fpp3/cnc/README.md

# cnc
Trabajo Practico Integrador de 4to año de la carrera Ingeniería Electrónica en la Universidad Tecnológica Nacional, Facultad Regional Córdoba. Materias involucradas: Electrónica Aplicada II, Técnicas Digitales II, Maquinas e Instalaciones Electricas
