fpp3/cnc/docs/anteproyecto/chapters/2-electronica_aplicada_2.tex

\chapter{Electrónica Aplicada II: Sensado de Corriente y Sensorless Endstops}
\label{sec:electronica_aplicada_2}

En el marco de la asignatura Electrónica Aplicada II, el proyecto aborda el diseño y análisis de una etapa analógica
orientada a la medición de corriente en los accionamientos y a la detección electrónica de límites mecánicos o
atascamientos (\textit{stall detection}).

\section{Justificación y Requerimientos del Módulo Analógico}
\label{sec:ea2_objetivos}

Los sistemas de mecanizado convencionales suelen emplear interruptores electromecánicos u ópticos como finales de
carrera. En este proyecto se propone aprovechar las herramientas del procesamiento analógico de señales para
desarrollar un sistema de detección de topes basado en la variación de corriente que experimentan los motores al
encontrar resistencia mecánica o alcanzar los extremos de desplazamiento.

La etapa analógica se concibe para satisfacer los siguientes requerimientos funcionales:
\begin{itemize}
  \item \textbf{Sensado de Corriente:} Conversión de la corriente de los devanados en una señal de tensión representativa,
    evaluando métodos de sensado resistivo (resistencias derivadoras o \textit{shunts}) o transductores de efecto Hall.
  \item \textbf{Acondicionamiento y Amplificación:} Adaptación de los niveles de señal al rango dinámico del conversor
    analógico-digital (ADC) del sistema de control, garantizando una alta relación de rechazo en modo común (CMRR)
    frente al ruido provocado por las conmutaciones de potencia.
  \item \textbf{Filtrado Analógico:} Atenuación de armónicos de alta frecuencia y transitorios derivados de la
    modulación por ancho de pulso (PWM) y conmutación de fases.
  \item \textbf{Discriminación de Umbral e Histéresis:} Generación de una señal digital de disparo rápido ante
    condiciones de sobrecorriente o atascamiento, incorporando histéresis para asegurar transiciones limpias y evitar
    falsos disparos por ruido.
\end{itemize}

\section{Estructura Funcional de la Etapa de Sensado}
\label{sec:ea2_estructura}

En la figura~\ref{crkt.ej2:sensado_opamp} se presenta el diagrama en bloques de la cadena de procesamiento analógico
propuesta.

\begin{figure}[!ht]
  \centering
  \resizebox{0.95\linewidth}{!}{\input{figures/crkt_ej2_sensado_opamp.tex}}
  \caption{Diagrama en bloques de la etapa analógica de sensado, acondicionamiento y discriminación de umbral.}
  \label{crkt.ej2:sensado_opamp}
\end{figure}

El diseño contempla una doble vía de aprovechamiento de la señal acondicionada:
\begin{enumerate}
  \item \textbf{Vía Continua (Monitoreo):} Envío de una señal analógica proporcional a la corriente media hacia el ADC,
    lo que permite supervisar en tiempo real el esfuerzo mecánico y evaluar el estado de carga durante el mecanizado.
  \item \textbf{Vía de Disparo Rápido (Seguridad):} Derivación hacia una etapa comparadora con histéresis analógica,
    cuya salida digital conmuta de forma determinística al sobrepasar el umbral de sobrecorriente previamente
    calibrado, activando una línea de proteccion analogica ante atascamientos severos producidos por la electronica de
    control.
\end{enumerate}

\section{Criterios de Diseño y Alternativas Tecnológicas}
\label{sec:ea2_criterios}

Durante el desarrollo del proyecto se evaluarán y seleccionarán las topologías más adecuadas en base a los
siguientes compromisos de ingeniería:

\begin{itemize}
  \item \textbf{Topología del Amplificador:} Análisis comparativo entre amplificadores operacionales en configuración
    diferencial y amplificadores de instrumentación dedicados, priorizando el rechazo a tensiones de modo común y la
    estabilidad térmica.
  \item \textbf{Respuesta en Frecuencia del Filtro:} Determinación del orden y tipo de filtrado (pasivo RC o activo de
    orden superior) para fijar una frecuencia de corte que elimine el rizado PWM sin degradar el tiempo de respuesta
    necesario para la protección mecánica ante impactos.
  \item \textbf{Ventana de Histéresis y Margen de Inmunidad:} Dimensionamiento de los umbrales de disparo superior e
    inferior del comparador, permitiendo calibrar la sensibilidad del final de carrera ante distintas cargas de trabajo
    y materiales a mecanizar.
\end{itemize}

\section{Flujo de Supervisión y Acción}
\label{sec:ea2_flujo}

La figura~\ref{fig.ej2:flujo_sensado} sintetiza la dinámica operativa del subsistema de sensado analógico y su
interacción con el controlador central.

\begin{figure}[!ht]
  \centering
  \resizebox{0.68\linewidth}{!}{\input{figures/fig_ej2_flujo_sensado.tex}}
  \caption{Flujo conceptual de supervisión de corriente y disparo de eventos de protección.}
  \label{fig.ej2:flujo_sensado}
\end{figure}

Este enfoque modular brinda la flexibilidad necesaria para ajustar parámetros analógicos y validar diferentes
tecnologías de transductores durante la etapa experimental de laboratorio.
