fpp3/cnc/docs/anteproyecto/chapters/1-introduccion.tex

\chapter{Introducción y Objetivos del Anteproyecto}
\label{sec:introduccion}

El presente anteproyecto documenta la propuesta para el Trabajo Integrador correspondiente al cuarto año de la
carrera de Ingeniería Electrónica en la Universidad Tecnológica Nacional, Facultad Regional Córdoba (UTN-FRC).
El objetivo central consiste en el diseño, desarrollo y validación experimental de una máquina de control numérico
computarizado (CNC) de tres ejes (X, Y, Z), orientada a aplicaciones de fresado ligero y prototipado rápido de
circuitos impresos (PCB).

Una particularidad tecnológica del proyecto reside en la reutilización sustentable de la estructura mecánica y
elementos de transmisión (guías lineales, husillos y chasis de soporte) provenientes de una impresora 3D fuera de uso.

\section{Integración Académica Interdisciplinaria}
\label{sec:integracion}

El trabajo integrador articula los conocimientos teóricos y prácticos de las siguientes tres materias:

\begin{itemize}
  \item \textbf{Electrónica Aplicada II:} Diseño de etapas analógicas de acondicionamiento de señal, sensado de
    corriente en los accionamientos y discriminación de umbral mediante comparación con histéresis para actuar como
    final de carrera electrónico y protección contra sobreesfuerzos o atascamientos mecánicos (\textit{stall detection}).
  \item \textbf{Técnicas Digitales II:} Diseño de la arquitectura del sistema embebido bajo un sistema operativo en
    tiempo real (RTOS), desarrollo del módulo interpretador de comandos de mecanizado normalizados (código G), gestión
    de periféricos por medio de la biblioteca CMSIS, generación determinística de impulsos de control y diseño de la
    interfaz hombre-máquina (HMI).
  \item \textbf{Máquinas e Instalaciones Eléctricas:} Diseño de controladores de potencia modulares por canal para el
    accionamiento de motores paso a paso (evaluando estrategias de conmutación y suavizado de movimiento) y de la etapa
    de regulación de potencia para el motor de la herramienta de corte (\textit{spindle}).
\end{itemize}

\section{Campos de Aplicación}
\label{sec:aplicacion}

La plataforma desarrollada posee aplicaciones concretas en diversos ámbitos:
\begin{enumerate}
  \item Prototipado rápido de placas de circuito impreso mediante ruteado directo por aislamiento (\textit{PCB milling}).
  \item Grabado y mecanizado liviano de materiales no ferrosos (madera, acrílico, MDF, placas FR4).
\end{enumerate}

\section{Arquitectura General del Sistema}
\label{sec:bloques_general}

El sistema global se estructura mediante una arquitectura modular distribuida en bloques funcionales, tal como se
esquematiza en la figura~\ref{fig.ej1:bloques_general}.

\begin{figure}[!ht]
  \centering
  \resizebox{0.92\linewidth}{!}{\input{figures/fig_ej1_bloques_general.tex}}
  \caption{Diagrama en bloques general del sistema CNC modular y su articulación por asignatura.}
  \label{fig.ej1:bloques_general}
\end{figure}

El controlador central ejecuta un sistema en tiempo real y se encarga de recibir las instrucciones de trabajo,
planificar las trayectorias de movimiento y emitir las señales de sincronismo hacia los módulos de potencia. A su vez,
las etapas de potencia ofrecen puntos de monitoreo para que el subsistema analógico supervise continuamente la
corriente consumida, garantizando la seguridad mecánica y eléctrica de la máquina.
