fpp3/cnc/docs/anteproyecto/chapters/4-maquinas_e_instalaciones_electricas.tex

\chapter{Máquinas e Instalaciones Eléctricas: Controladores de Potencia y Accionamientos}
\label{sec:maquinas_e_instalaciones_electricas}

En la asignatura Máquinas e Instalaciones Eléctricas, el anteproyecto desarrolla el diseño electromecánico y de
potencia para los actuadores de la CNC. Esto abarca los controladores modulares de velocidad y sentido de giro para
los motores paso a paso de los tres ejes cartesianos y el regulador de potencia para la herramienta de corte (\textit{spindle}).

\section{Topología Modular por Canal de Accionamiento}
\label{sec:myie_modularidad}

Para garantizar un mantenimiento sencillo, aislar fallas entre ejes y facilitar la escalabilidad del sistema, se adopta
una arquitectura de potencia modular e independiente por cada eje mecánico (X, Y, Z).

Cada módulo de canal integra funcionalmente:
\begin{itemize}
  \item La interfaz lógica de recepción y decodificación de las señales de control de movimiento (paso, dirección y
    habilitación).
  \item Las etapas de conmutación de potencia (puentes H) encargadas de energizar las fases de los motores con la
    secuencia y magnitud adecuadas.
  \item Un punto de derivación de retorno para la toma de señal de corriente, permitiendo la interacción con la etapa
    de acondicionamiento analógico de Electrónica Aplicada II.
\end{itemize}

En la figura~\ref{crkt.ej4:driver_paso_a_paso} se presenta la estructura de bloques de un canal modular de accionamiento.

\begin{figure}[!ht]
  \centering
  \resizebox{0.95\linewidth}{!}{\input{figures/crkt_ej4_driver_paso_a_paso.tex}}
  \caption{Diagrama de bloques funcional de un módulo de potencia por canal para motores paso a paso.}
  \label{crkt.ej4:driver_paso_a_paso}
\end{figure}

\section{Control de Motores Paso a Paso y Estrategias de Excitación}
\label{sec:myie_paso_a_paso}

Los motores recuperados de los mecanismos de impresión son del tipo NEMA bipolar. El módulo de potencia debe asegurar 
la conmutación controlada de corriente en los bobinados.

Durante la fase de diseño se evaluarán diferentes esquemas de excitación de fases:
\begin{itemize}
  \item \textbf{Paso Completo y Medio Paso (\textit{Full/Half Step}):} Secuencias discretas de conmutación directa, de
    implementación robusta y alto torque estático, analizando su impacto sobre las vibraciones mecánicas del chasis.
  \item \textbf{Pasos Fraccionados (\textit{Microstepping}):} Modulación de la corriente promedio en cada devanado para
    subdividir el ángulo de paso nativo del motor, reduciendo resonancias electromecánicas y logrando un desplazamiento
    más suave y silencioso.\footnote{La posibilidad de implementar microstepping se evaluará al momento de comenzar el
    trabajo integrador.}
\end{itemize}

\section{Controlador de Potencia para el Motor de la Herramienta (Spindle)}
\label{sec:myie_spindle}

El cabezal de mecanizado requiere un motor de corriente continua capaz de girar a altas revoluciones para garantizar un
correcto corte del cobre y materiales no ferrosos. La velocidad angular debe ser regulable para adaptarse a los
diámetros de fresa y velocidades de avance requeridas.

La etapa de potencia implementará conmutación de estado sólido controlada por modulación por ancho de pulso (PWM),
permitiendo variar la tensión media aplicada al motor de manera eficiente. En la figura~\ref{crkt.ej4:driver_spindle} se
ilustra el esquema funcional de esta etapa.

\begin{figure}[!ht]
  \centering
  \resizebox{0.85\linewidth}{!}{\input{figures/crkt_ej4_driver_spindle.tex}}
  \caption{Diagrama funcional del controlador de potencia para el motor de corte (\textit{spindle}).}
  \label{crkt.ej4:driver_spindle}
\end{figure}

Dado el carácter fuertemente inductivo del motor DC, el diseño incorpora redes de protección contra sobretensiones y
transitorios provocados durante los bloqueos de conmutación (diodos de recirculación rápida y redes de absorción de
picos), preservando los dispositivos de conmutación y reduciendo las interferencias electromagnéticas (EMI) sobre el
resto del sistema.
