fpp3/cnc/docs/anteproyecto/chapters/5-conclusiones.tex

\chapter{Conclusiones y Plan de Trabajo}
\label{sec:conclusiones}

El anteproyecto presentado demuestra la viabilidad técnica y metodológica de construir una máquina de control numérico
computarizado orientada al prototipado de circuitos impresos, reutilizando una immpresora 3D desuso como base y
articulando armónicamente los contenidos teóricos y prácticos de tres asignaturas troncales del cuarto año de
Ingeniería Electrónica.

\section{Resumen de Integración Técnica}
\label{sec:resumen_integracion}

La tabla~\ref{tab.ej5:resumen_materias} sintetiza la distribución de responsabilidades técnicas y los ejes de estudio
por asignatura.

\begin{table}[!ht]
  \centering
  \resizebox{\textwidth}{!}{
    \begin{tabular}{|l|p{6cm}|p{6cm}|}
      \hline
      \textbf{Asignatura} & \textbf{Módulo del Proyecto} & \textbf{Conceptos Clave Aplicados} \\ \hline
      Electrónica Aplicada II & Sensado de corriente y final de carrera electrónico & Procesamiento analógico de señales, acondicionamiento diferencial/instrumentación, filtrado de ruido de conmutación, comparadores con histéresis analógica, monitoreo vía ADC. \\ \hline
      Técnicas Digitales II & Controlador embebido en tiempo real e interfaz HMI & Sistemas operativos en tiempo real (RTOS), planificación concurrente, comunicación interproceso (IPC), interpretación de código G, gestión de periféricos serie, temporizadores por hardware y manejo de interrupciones. \\ \hline
      Máquinas e Inst. Eléctricas & Controladores modulares de motores PaP y Spindle & Máquinas eléctricas especiales, accionamiento de motores paso a paso, análisis de estrategias de conmutación (paso completo / micropasos), modulación PWM, puentes H y protección de conmutación inductiva. \\ \hline
    \end{tabular}
  }
  \caption{Matriz de integración conceptual por asignatura académica.}
  \label{tab.ej5:resumen_materias}
\end{table}

\section{Plan de Trabajo y Etapas de Desarrollo}
\label{sec:pasos_futuros}

A partir de los lineamientos fijados en este anteproyecto, el desarrollo del proyecto se estructurará en las siguientes
etapas:
\begin{enumerate}
  \item \textbf{Caracterización Mecánica y de Actuadores:} Relevamiento y evaluación de los chasis de impresora disponibles,
    determinando rangos de desplazamiento, relaciones de transmisión y parámetros eléctricos de los motores recuperados.
  \item \textbf{Modelado y Simulación Analógica:} Simulación computacional de las distintas alternativas de acondicionamiento
    de señal, filtrado y detección de umbral para optimizar la inmunidad al ruido y tiempos de respuesta.
  \item \textbf{Diseño y Fabricación Electrónica:} Diseño esquemático y ruteado de los circuitos impresos (PCB) para los
    módulos de potencia y etapas de acondicionamiento analógico.
  \item \textbf{Desarrollo del Firmware Embebido:} Implementación modular del software sobre el sistema RTOS seleccionado,
    validando tiempos de respuesta, latencias de interrupción y correcta interpretación de trayectorias.
  \item \textbf{Integración, Calibración y Ensayos:} Ensamble global del sistema, calibración de pasos por milímetro,
    ajuste de los umbrales de detección electrónica de fin de carrera y pruebas de fresado sobre placas de circuito impreso.
\end{enumerate}
