fpp3/cnc/docs/anteproyecto/figures/crkt_ej2_sensado_opamp.tex

\begin{tikzpicture}[
  >=stealth, thick,
  font=\small,
  node distance=1.2cm and 1.8cm,
  block/.style={draw=blue!70!black, fill=blue!10, rectangle, rounded corners=4pt, minimum height=1.1cm, minimum width=2.5cm, align=center},
  inputnode/.style={draw=gray!70!black, fill=gray!12, rectangle, rounded corners=4pt, minimum height=1.1cm, minimum width=2.4cm, align=center},
  outnode/.style={draw=green!60!black, fill=green!12, rectangle, rounded corners=4pt, minimum height=1.1cm, minimum width=2.6cm, align=center}
]

  % Fila 1: Cadena Analógica Principal
  \node[inputnode] (trans) {Sensado\\{\footnotesize ($I_{motor}$ / Shunt)}};
  \node[block, right=of trans] (amp) {Ganancia y\\Acondic.\\{\footnotesize (Diferencial)}};
  \node[block, right=of amp] (filtro) {Filtrado\\Pasa-Bajos\\{\footnotesize (Rechazo PWM)}};
  \node[outnode, right=of filtro] (adc) {Salida Analógica\\{\footnotesize ($V_{ana} \rightarrow$ ADC MCU)}};

  % Fila 2: Etapa de Comparación y Disparo
  \node[block, below=1.3cm of filtro] (comp) {Comparador con\\Histéresis\\{\footnotesize (Schmitt Trigger)}};
  \node[outnode, right=of comp] (exti) {Disparo Emergencia\\{\footnotesize (Tope)}};

  % Conexiones Horizontales con etiquetas arriba
  \draw[->] (trans) -- node[above, font=\footnotesize] {$V_{sens}$} (amp);
  \draw[->] (amp) -- node[above, font=\footnotesize] {$V_{amp}$} (filtro);
  \draw[->] (filtro) -- node[above, font=\footnotesize] {$V_{ana}$} (adc);

  % Conexión vertical directa hacia la etapa comparadora
  \draw[->] (filtro) -- node[right, font=\footnotesize] {$V_{ana}$} (comp);
  \draw[->] (comp) -- (exti);

  % Entrada de umbral de referencia
  \draw[<-] (comp.south) -- ++(0,-0.7) node[below, font=\footnotesize] {Umbral Ref. ($V_{ref}$)};

\end{tikzpicture}
