fpp3/cnc/docs/anteproyecto/figures/crkt_ej4_driver_paso_a_paso.tex

\begin{tikzpicture}[
  >=stealth, thick,
  font=\small,
  node distance=1.2cm and 2.0cm,
  block/.style={draw=orange!80!black, fill=orange!12, rectangle, rounded corners=4pt, minimum height=1.2cm, minimum width=2.9cm, align=center},
  ctrl/.style={draw=blue!70!black, fill=blue!10, rectangle, rounded corners=4pt, minimum height=1.0cm, minimum width=2.5cm, align=center},
  sens/.style={draw=purple!70!black, fill=purple!10, rectangle, rounded corners=4pt, minimum height=0.9cm, minimum width=2.9cm, align=center},
  motor/.style={draw=green!60!black, fill=green!10, rectangle, rounded corners=4pt, minimum height=1.2cm, minimum width=2.6cm, align=center, font=\small\bfseries}
]

  % Bloques principales
  \node[ctrl] (ctrl) {Señales de Control\\{\footnotesize (STEP / DIR / EN)}};
  \node[block, right=1.6cm of ctrl] (logic) {Lógica de Control\\y Modulación\\{\footnotesize (Secuenciador / Chopper)}};
  \node[block, right=2.0cm of logic] (power) {Etapa de Potencia\\{\footnotesize (Puentes H / Fases A y B)}};
  \node[sens, below=1.2cm of power] (sens) {Retorno de Masa y\\Punto de Sensado};
  \node[motor, right=2.0cm of power] (motor) {Motor PaP\\{\footnotesize (Eje X / Y / Z)}};

  % Contenedor Modular (Caja con margen superior amplio de 1.8cm para no colisionar con la alimentación)
  \draw[dashed, draw=gray!60, rounded corners=6pt] 
    ([xshift=-0.5cm, yshift=2.0cm]logic.north west) rectangle 
    ([xshift=0.5cm, yshift=-0.4cm]sens.south east);
  \node[anchor=north west, font=\footnotesize\bfseries\color{black!75}] 
    at ([xshift=-0.35cm, yshift=1.85cm]logic.north west) {Módulo de Potencia por Canal (PCB Independiente)};

  % Conexiones con etiquetas centradas
  \draw[->] (ctrl) -- (logic);
  \draw[->] (logic) -- node[above, font=\footnotesize] {Comando} (power);
  \draw[->] (power) -- node[above, font=\footnotesize] {Fases} (motor);
  \draw[->] (power) -- (sens);
  \draw[->, draw=purple!80!black] (sens.east) -| node[pos=0.25, below, font=\footnotesize] {Hacia Etapa EA2} ([xshift=-0.3cm]motor.south);

  % Alimentación con espacio holgado
  \draw[<-] (power.north) -- ++(0,0.8) node[above, font=\footnotesize] {Alimentación $V_{mot}$};

\end{tikzpicture}
