fpp3/cnc/docs/anteproyecto/figures/crkt_ej4_driver_spindle.tex

\begin{tikzpicture}[
  >=stealth, thick,
  font=\small,
  node distance=1.0cm and 2.2cm,
  ctrl/.style={draw=blue!70!black, fill=blue!10, rectangle, rounded corners=4pt, minimum height=1.1cm, minimum width=2.6cm, align=center},
  block/.style={draw=orange!80!black, fill=orange!12, rectangle, rounded corners=4pt, minimum height=1.1cm, minimum width=2.8cm, align=center},
  motor/.style={draw=green!60!black, fill=green!10, rectangle, rounded corners=4pt, minimum height=1.1cm, minimum width=2.6cm, align=center, font=\small\bfseries}
]

  \node[ctrl] (ctrl) {Consigna PWM\\{\footnotesize (Temporizador MCU)}};
  \node[block, right=2.2cm of ctrl] (driver) {Acondicionamiento /\\Driver de Compuerta};
  \node[block, right=2.2cm of driver] (switch) {Conmutación y\\Supresión Inductiva};
  \node[motor, right=2.8cm of switch] (motor) {Motor DC\\{\footnotesize (Spindle / Fresa)}};

  % Conexiones lineales con espacio amplio para las etiquetas
  \draw[->] (ctrl) -- node[above, font=\footnotesize] {PWM} (driver);
  \draw[->] (driver) -- node[above, font=\footnotesize] {Disparo} (switch);
  \draw[->] (switch) -- node[above, font=\footnotesize] {Tensión Media} (motor);

  % Alimentación de potencia
  \draw[<-] (switch.north) -- ++(0,0.8) node[above, font=\footnotesize] {Alimentación $V_{DC}$};

\end{tikzpicture}
