fpp3/cnc/docs/anteproyecto/figures/fig_ej1_bloques_general.tex

\begin{tikzpicture}[
  >=stealth, thick,
  font=\small,
  node distance=1.6cm and 2.4cm,
  mcu/.style={draw=blue!70!black, fill=blue!10, rectangle, rounded corners=4pt, minimum height=1.3cm, minimum width=3.6cm, align=center, font=\small\bfseries},
  peri/.style={draw=cyan!70!black, fill=cyan!10, rectangle, rounded corners=4pt, minimum height=1.1cm, minimum width=2.6cm, align=center},
  power/.style={draw=orange!80!black, fill=orange!12, rectangle, rounded corners=4pt, minimum height=1.2cm, minimum width=3.6cm, align=center, font=\small\bfseries},
  analog/.style={draw=purple!70!black, fill=purple!10, rectangle, rounded corners=4pt, minimum height=1.2cm, minimum width=2.8cm, align=center, font=\small\bfseries},
  mech/.style={draw=green!60!black, fill=green!10, rectangle, rounded corners=4pt, minimum height=1.1cm, minimum width=3.6cm, align=center, font=\small\bfseries}
]

  % Fila 1: Controlador Central y Periféricos
  \node[mcu] (mcu) {Controlador Central\\{\footnotesize (Sistema Embebido / TD2)}};
  \node[peri, left=of mcu] (hmi) {Interfaz HMI\\{\footnotesize (Pantalla / Encoder)}};
  \node[peri, right=of mcu] (storage) {Almacenamiento\\{\footnotesize (Tarjeta SD / SPI)}};

  % Fila 2: Potencia y Sensado
  \node[power, below=2.0cm of mcu] (power) {Controladores de Potencia\\{\footnotesize (Ejes X, Y, Z y Spindle / MEIE)}};
  \node[analog, left=of power] (analog) {Sensado Analógico\\y Protección\\{\footnotesize (Acond. / EA2)}};

  % Fila 3: Mecánica y Actuadores
  \node[mech, below=1.5cm of power] (mech) {Plataforma Mecánica\\{\footnotesize (Chasis, Motores PaP y Fresa)}};

  % Conexiones superiores
  \draw[<->, draw=cyan!80!black] (hmi) -- node[above, font=\footnotesize] {I2C / GPIO} (mcu);
  \draw[<->, draw=cyan!80!black] (storage) -- node[above, font=\footnotesize] {SPI} (mcu);

  % Conexión MCU -> Potencia (Línea recta vertical)
  \draw[->, draw=orange!80!black] (mcu) -- node[right, font=\footnotesize] {STEP / DIR / PWM} (power);

  % Conexión Potencia -> Mecánica
  \draw[->, draw=green!60!black] (power) -- node[right, font=\footnotesize] {Alimentación Fases} (mech);

  % Conexión Potencia -> Sensado Analógico
  \draw[->, draw=purple!80!black] (power) -- node[above, font=\footnotesize] {Señal Shunt} (analog);

  % Conexión Sensado -> MCU (Sube por la izquierda y entra en el lateral izquierdo del MCU, SIN CRUZAR la línea central)
  \draw[->, draw=purple!80!black] (analog.north) -- ++(0, 0.9) -| node[pos=0.25, above, font=\footnotesize] {EXTI / ADC} ([yshift=-2mm]mcu.west);

\end{tikzpicture}
