fpp3/cnc/docs/anteproyecto/figures/fig_ej3_flujo_gcode.tex

\begin{tikzpicture}[
  >=stealth, thick,
  font=\small,
  node distance=1.1cm,
  startstop/.style={draw=green!60!black, fill=green!12, rectangle, rounded corners=4pt, minimum height=0.9cm, minimum width=3.4cm, align=center, font=\small\bfseries},
  process/.style={draw=blue!70!black, fill=blue!10, rectangle, rounded corners=4pt, minimum height=1.0cm, minimum width=3.6cm, align=center},
  decision/.style={draw=yellow!60!black, fill=yellow!20, diamond, aspect=2, inner sep=3pt, align=center, font=\small},
  errornode/.style={draw=red!70!black, fill=red!10, rectangle, rounded corners=4pt, minimum height=0.9cm, minimum width=2.6cm, align=center, font=\footnotesize}
]

  \node[startstop] (start) {Recepción de Bloque G-Code};
  \node[process, below=of start] (parse) {Extracción de Comando\\y Parámetros (X, Y, Z, F, S)};
  \node[decision, below=1.3cm of parse] (valid) {¿Sintaxis\\Válida?};
  \node[errornode, right=1.6cm of valid] (error) {Notificar Error\\(HMI / Serie)};
  \node[process, below=1.3cm of valid] (calc) {Cálculo Cinemático y\\Conversión a Pasos};
  \node[process, below=of calc] (plan) {Perfilado de Velocidad\\y Aceleración};
  \node[process, below=of plan] (queue) {Inserción en Cola\\de Movimiento};
  \node[startstop, below=of queue] (exec) {Generación de Pulsos\\por Temporizadores};

  % Conexiones verticales principales
  \draw[->] (start) -- (parse);
  \draw[->] (parse) -- (valid);
  \draw[->] (valid) -- node[right, font=\footnotesize\bfseries] {Sí} (calc);
  \draw[->] (valid) -- node[above, font=\footnotesize\bfseries] {No} (error);
  \draw[->] (calc) -- (plan);
  \draw[->] (plan) -- (queue);
  \draw[->] (queue) -- (exec);

  % Retorno de error limpio hacia la entrada del paso de recepción
  \draw[->] (error.north) |- (start.east);

\end{tikzpicture}
