fpp3/cnc/ctrl_main/cnc_driverboard/cnc_driverboard.kicad_pcb

## KiCad design ctrl_main/cnc_driverboard/cnc_driverboard.kicad_pcb (2026-11-11)

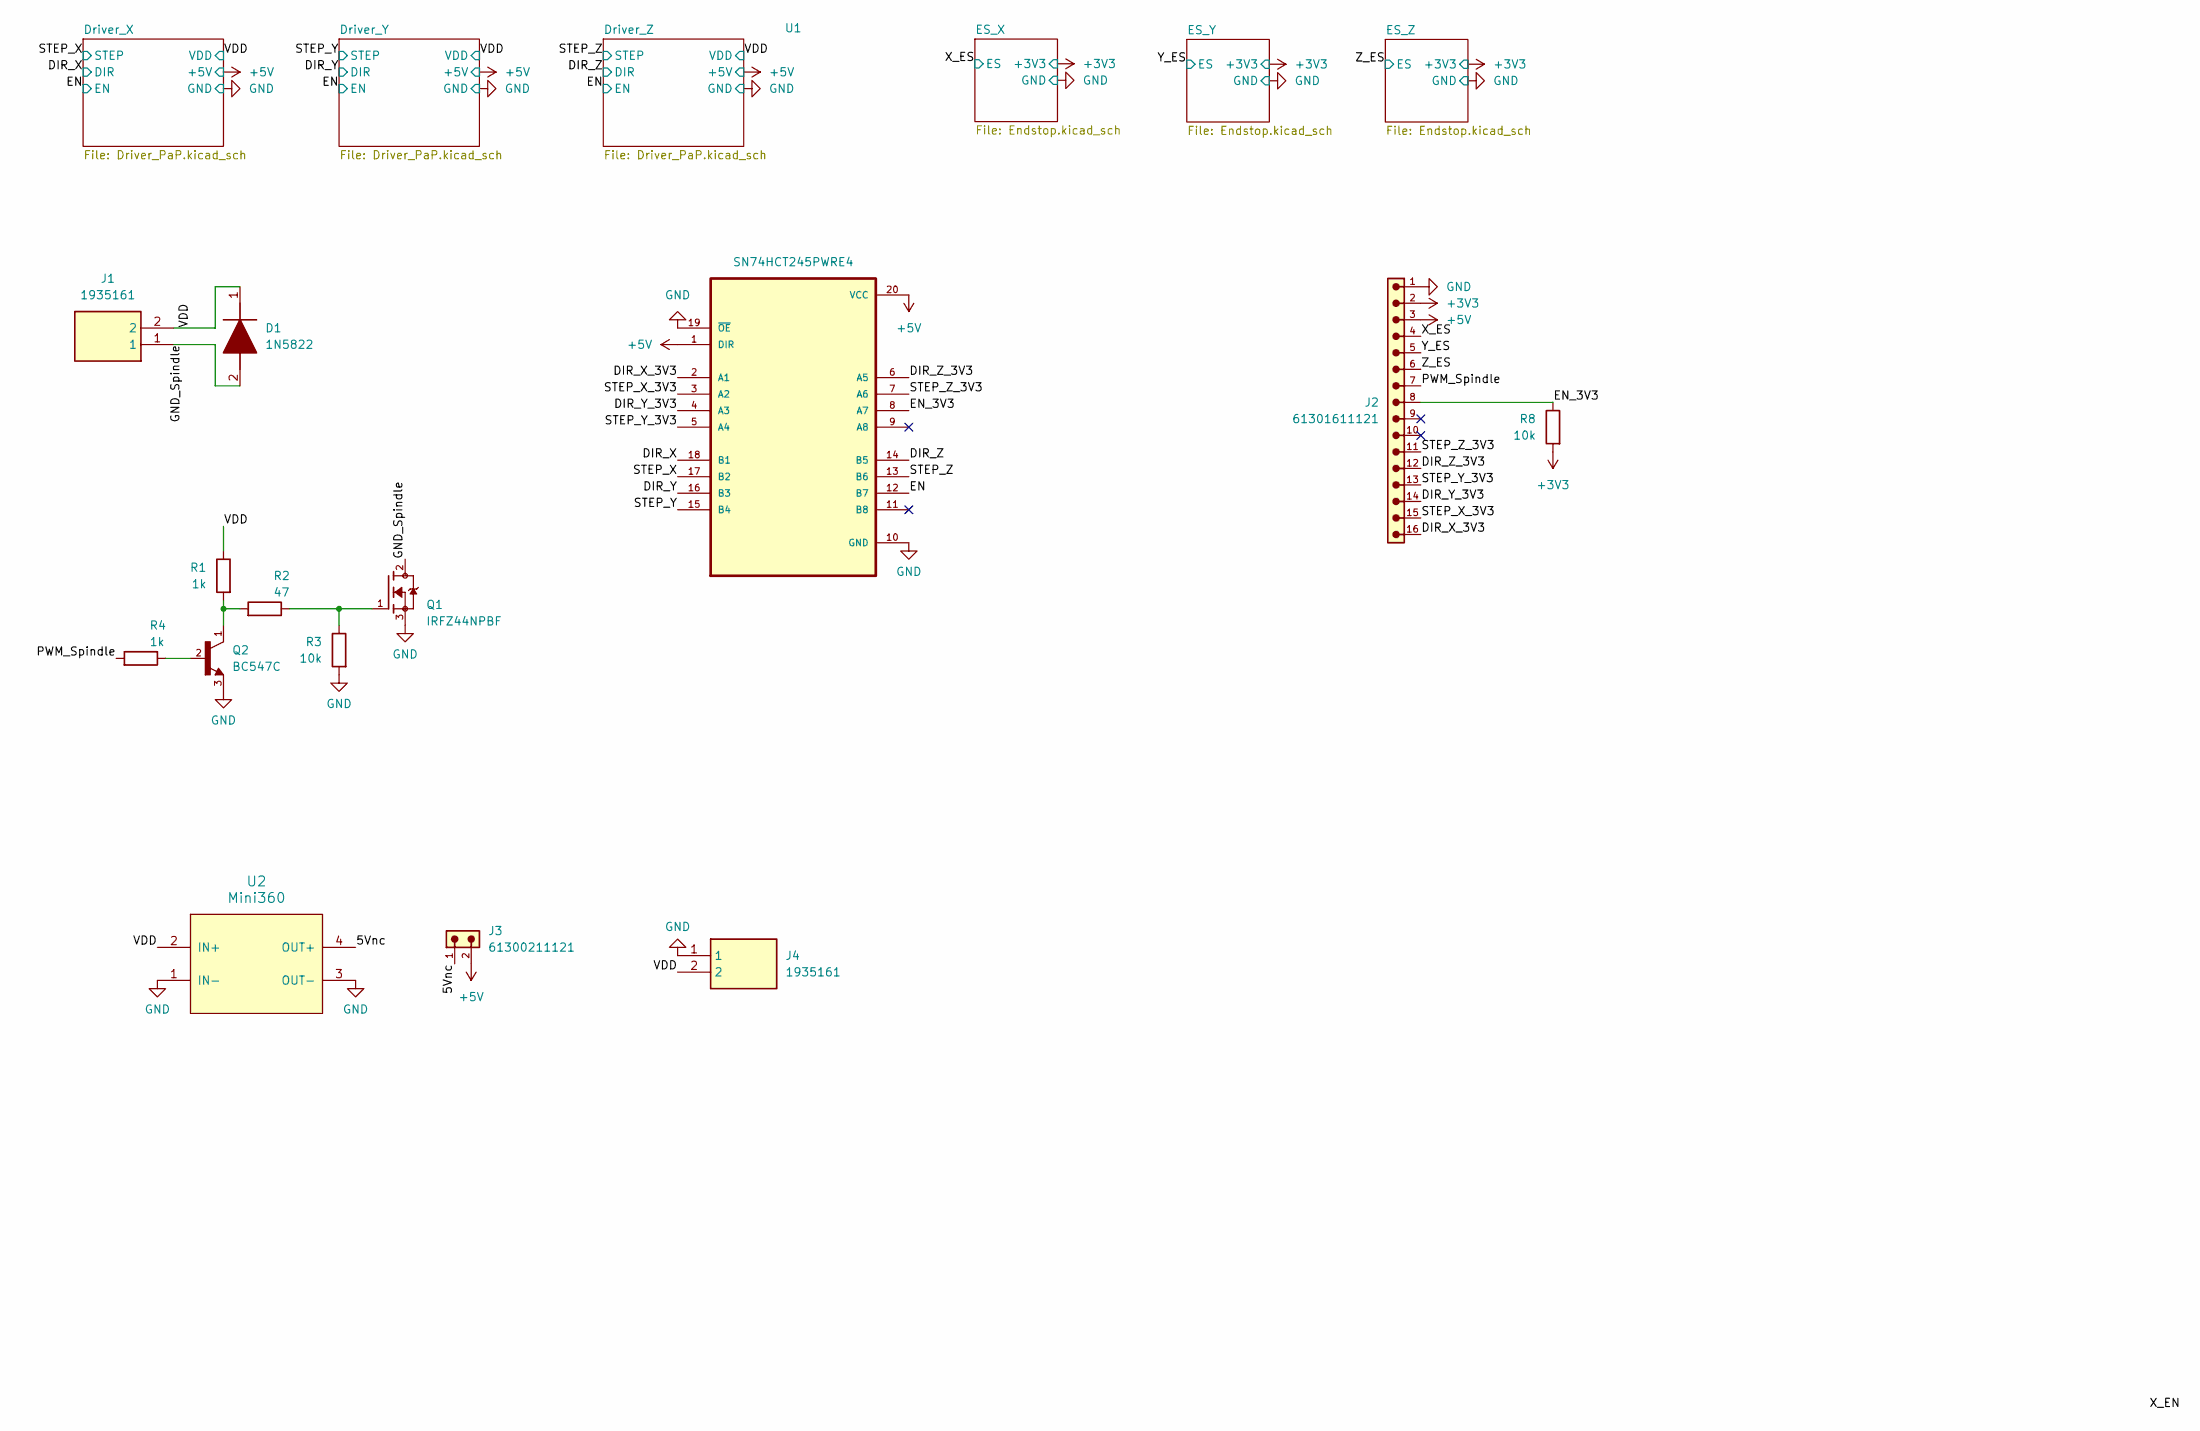
[picture p9: schematic cnc_driverboard.kicad_sch]

Parts:
D1: 1N5822; DIOAD3070W130L950D530; Manufacturer_Part_Number 1N5822; Mouser Part Number 512-1N5822
J1, J4: 1935161; Manufacturer_Part_Number 1935161; Mouser Part Number 651-1935161
J2: 61301611121; MPN 61301611121
J3: 61300211121; MPN 61300211121
Q1: IRFZ44NPBF; TO254P1016X419X2286-3; MPN IRFZ44NPBF
Q2: BC547C; TRANS_BC547C; MPN BC547C
R1, R4: 1k; R_Axial_DIN0207_L6.3mm_D2.5mm_P7.62mm_Horizontal
R2: 47; R_Axial_DIN0207_L6.3mm_D2.5mm_P7.62mm_Horizontal
R3: 10k; R_Axial_DIN0207_L6.3mm_D2.5mm_P7.62mm_Horizontal
R8: 10k; R_Axial_DIN0207_L6.3mm_D2.5mm_P15.24mm_Horizontal
U1: SN74HCT245PWRE4; SOP65P640X120-20N; MPN SN74HCT245PWRE4
U2: Mini360; Mini360_step-down

Connections:
+3V3: J2.2, R8.2; also elsewhere on the board
+5V: J2.3, J3.2, U1.1 (DIR), U1.20 (VCC); also elsewhere on the board
/5Vnc: J3.1, U2.4 (OUT+)
/DIR_X: U1.18 (B1); also elsewhere on the board
/DIR_X_3V3: J2.16, U1.2 (A1)
/DIR_Y: U1.16 (B3); also elsewhere on the board
/DIR_Y_3V3: J2.14, U1.4 (A3)
/DIR_Z: U1.14 (B5); also elsewhere on the board
/DIR_Z_3V3: J2.12, U1.6 (A5)
/EN: U1.12 (B7); also elsewhere on the board
/EN_3V3: J2.8, R8.1, U1.8 (A7)
/GND_Spindle: D1.2 (A), J1.1, Q1.2
/PWM_Spindle: J2.7, R4.2
/STEP_X: U1.17 (B2); also elsewhere on the board
/STEP_X_3V3: J2.15, U1.3 (A2)
/STEP_Y: U1.15 (B4); also elsewhere on the board
/STEP_Y_3V3: J2.13, U1.5 (A4)
/STEP_Z: U1.13 (B6); also elsewhere on the board
/STEP_Z_3V3: J2.11, U1.7 (A6)
/VDD: D1.1 (K), J1.2, J4.2, R1.1, U2.2 (IN+); also elsewhere on the board
/X_ES: J2.4; also elsewhere on the board
/Y_ES: J2.5; also elsewhere on the board
/Z_ES: J2.6; also elsewhere on the board
GND: J2.1, J4.1, Q1.3, Q2.3, R3.2, U1.10 (GND), U1.19 (~OE), U2.1 (IN-), U2.3 (OUT-); also elsewhere on the board
unnamed: Q1.1, R2.1, R3.1
unnamed: Q2.1, R1.2, R2.2
unnamed: Q2.2, R4.1

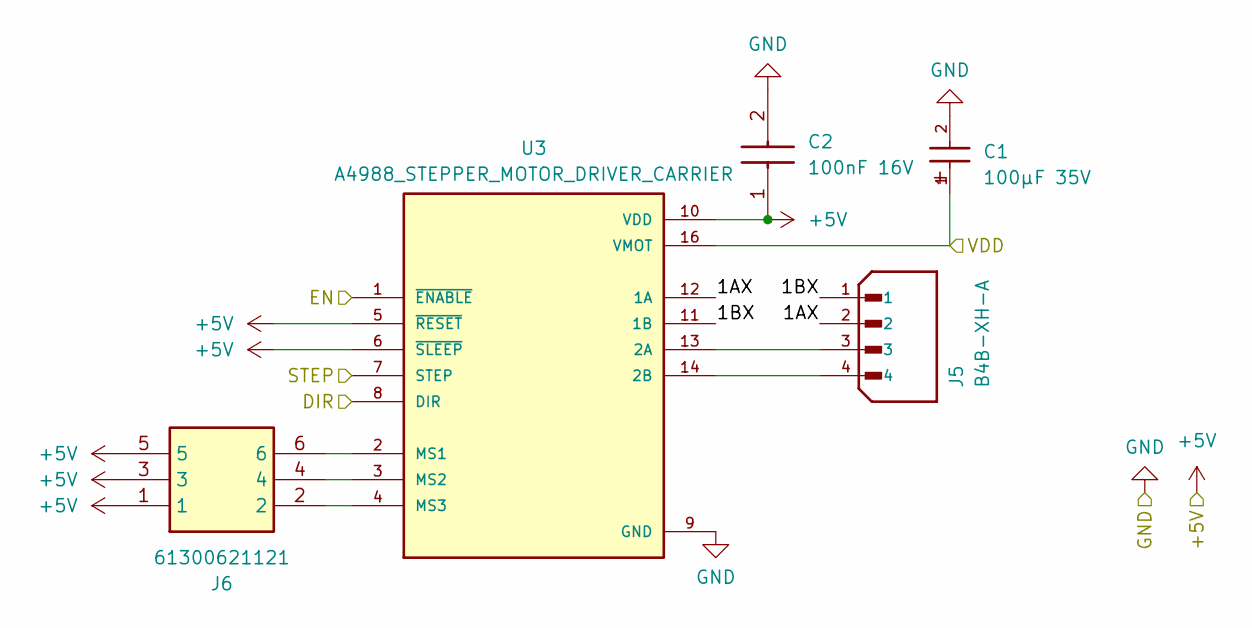
[picture p10: schematic Driver_PaP.kicad_sch]

Parts:
C1: 100µF 35V; WCAP-ATUL_6.3X11_DXL_; MPN WCAP-ATUL_6.3X11
C2: 100nF 16V; CAPC2012X95N; MPN CC0805KRX7R7BB104; Mouser Part Number 603-CC805KRX7R7BB104
J5: B4B-XH-A; JST_B4B-XH-A; MPN B4B-XH-A
J6: 61300621121; HDRV6W64P254_2X3_762X508X889P; Manufacturer_Part_Number 61300621121; Mouser Part Number 710-61300621121
U3: A4988_STEPPER_MOTOR_DRIVER_CARRIER; MODULE_A4988_STEPPER_MOTOR_DRIVER_CARRIER; MPN A4988 STEPPER MOTOR DRIVER CARRIER

Connections:
+5V: C2.1, J6.1, J6.3, J6.5, U3.5 (~RESET), U3.6 (~SLEEP), U3.10 (VDD); also elsewhere on the board
/DIR_X: U3.8 (DIR); also elsewhere on the board
/Driver_X/1AX: J5.2, U3.12 (1A)
/Driver_X/1BX: J5.1, U3.11 (1B)
/EN: U3.1 (~ENABLE); also elsewhere on the board
/STEP_X: U3.7 (STEP); also elsewhere on the board
/VDD: C1.1, U3.16 (VMOT); also elsewhere on the board
GND: C1.2, C2.2, U3.9 (GND), U3.15 (GND); also elsewhere on the board
unnamed: J5.3, U3.13 (2A)
unnamed: J5.4, U3.14 (2B)
unnamed: J6.6, U3.2 (MS1)
unnamed: J6.4, U3.3 (MS2)
unnamed: J6.2, U3.4 (MS3)

Parts of its further copies:
C3, C5: 100µF 35V; WCAP-ATUL_6.3X11_DXL_; MPN WCAP-ATUL_6.3X11
C4, C6: 100nF 16V; CAPC2012X95N; MPN CC0805KRX7R7BB104; Mouser Part Number 603-CC805KRX7R7BB104
J7, J9: B4B-XH-A; JST_B4B-XH-A; MPN B4B-XH-A
J8, J10: 61300621121; HDRV6W64P254_2X3_762X508X889P; Manufacturer_Part_Number 61300621121; Mouser Part Number 710-61300621121
U4, U5: A4988_STEPPER_MOTOR_DRIVER_CARRIER; MODULE_A4988_STEPPER_MOTOR_DRIVER_CARRIER; MPN A4988 STEPPER MOTOR DRIVER CARRIER

Connections of its further copies:
+5V: C4.1, C6.1, J8.1, J8.3, J8.5, J10.1, J10.3, J10.5, U4.5 (~RESET), U4.6 (~SLEEP), U4.10 (VDD), U5.5 (~RESET), U5.6 (~SLEEP), U5.10 (VDD); also elsewhere on the board
/DIR_Y: U4.8 (DIR); also elsewhere on the board
/DIR_Z: U5.8 (DIR); also elsewhere on the board
/Driver_Y/1AX: J7.2, U4.12 (1A)
/Driver_Y/1BX: J7.1, U4.11 (1B)
/Driver_Z/1AX: J9.2, U5.12 (1A)
/Driver_Z/1BX: J9.1, U5.11 (1B)
/EN: U4.1 (~ENABLE), U5.1 (~ENABLE); also elsewhere on the board
/STEP_Y: U4.7 (STEP); also elsewhere on the board
/STEP_Z: U5.7 (STEP); also elsewhere on the board
/VDD: C3.1, C5.1, U4.16 (VMOT), U5.16 (VMOT); also elsewhere on the board
GND: C3.2, C4.2, C5.2, C6.2, U4.9 (GND), U4.15 (GND), U5.9 (GND), U5.15 (GND); also elsewhere on the board
unnamed: J7.3, U4.13 (2A)
unnamed: J7.4, U4.14 (2B)
unnamed: J8.6, U4.2 (MS1)
unnamed: J8.4, U4.3 (MS2)
unnamed: J8.2, U4.4 (MS3)
unnamed: J9.3, U5.13 (2A)
unnamed: J9.4, U5.14 (2B)
unnamed: J10.6, U5.2 (MS1)
unnamed: J10.4, U5.3 (MS2)
unnamed: J10.2, U5.4 (MS3)

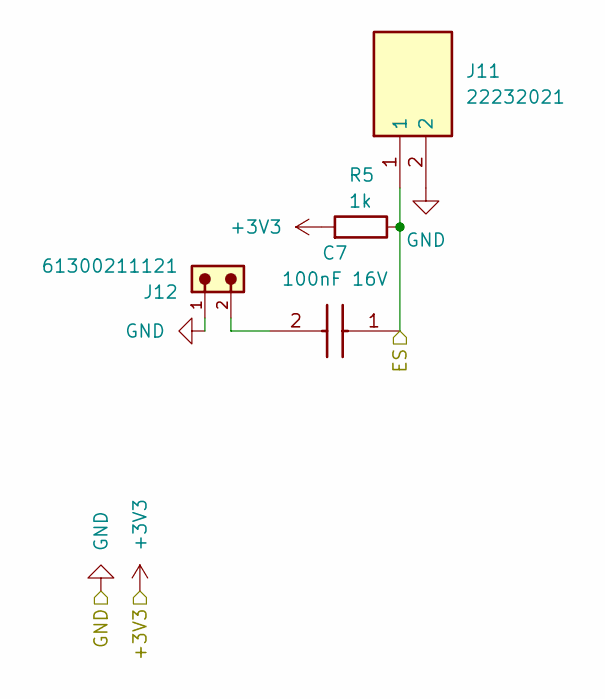
[picture p11: schematic Endstop.kicad_sch]

Parts:
C7: 100nF 16V; CAPC2012X95N; MPN CC0805KRX7R7BB104; Mouser Part Number 603-CC805KRX7R7BB104
J11: 22232021; CONN_A-6373-02A_MOL; Manufacturer_Part_Number 1935161; Mouser Part Number 651-1935161
J12: 61300211121; MPN 61300211121
R5: 1k; R_Axial_DIN0207_L6.3mm_D2.5mm_P7.62mm_Horizontal

Connections:
+3V3: R5.2; also elsewhere on the board
/X_ES: C7.1, J11.1, R5.1; also elsewhere on the board
GND: J11.2, J12.1; also elsewhere on the board
unnamed: C7.2, J12.2

Parts of its further copies:
C8, C9: 100nF 16V; CAPC2012X95N; MPN CC0805KRX7R7BB104; Mouser Part Number 603-CC805KRX7R7BB104
J13, J15: 22232021; CONN_A-6373-02A_MOL; Manufacturer_Part_Number 1935161; Mouser Part Number 651-1935161
J14, J16: 61300211121; MPN 61300211121
R6, R7: 1k; R_Axial_DIN0207_L6.3mm_D2.5mm_P7.62mm_Horizontal

Connections of its further copies:
+3V3: R6.2, R7.2; also elsewhere on the board
/Y_ES: C8.1, J13.1, R6.1; also elsewhere on the board
/Z_ES: C9.1, J15.1, R7.1; also elsewhere on the board
GND: J13.2, J14.1, J15.2, J16.1; also elsewhere on the board
unnamed: C8.2, J14.2
unnamed: C9.2, J16.2

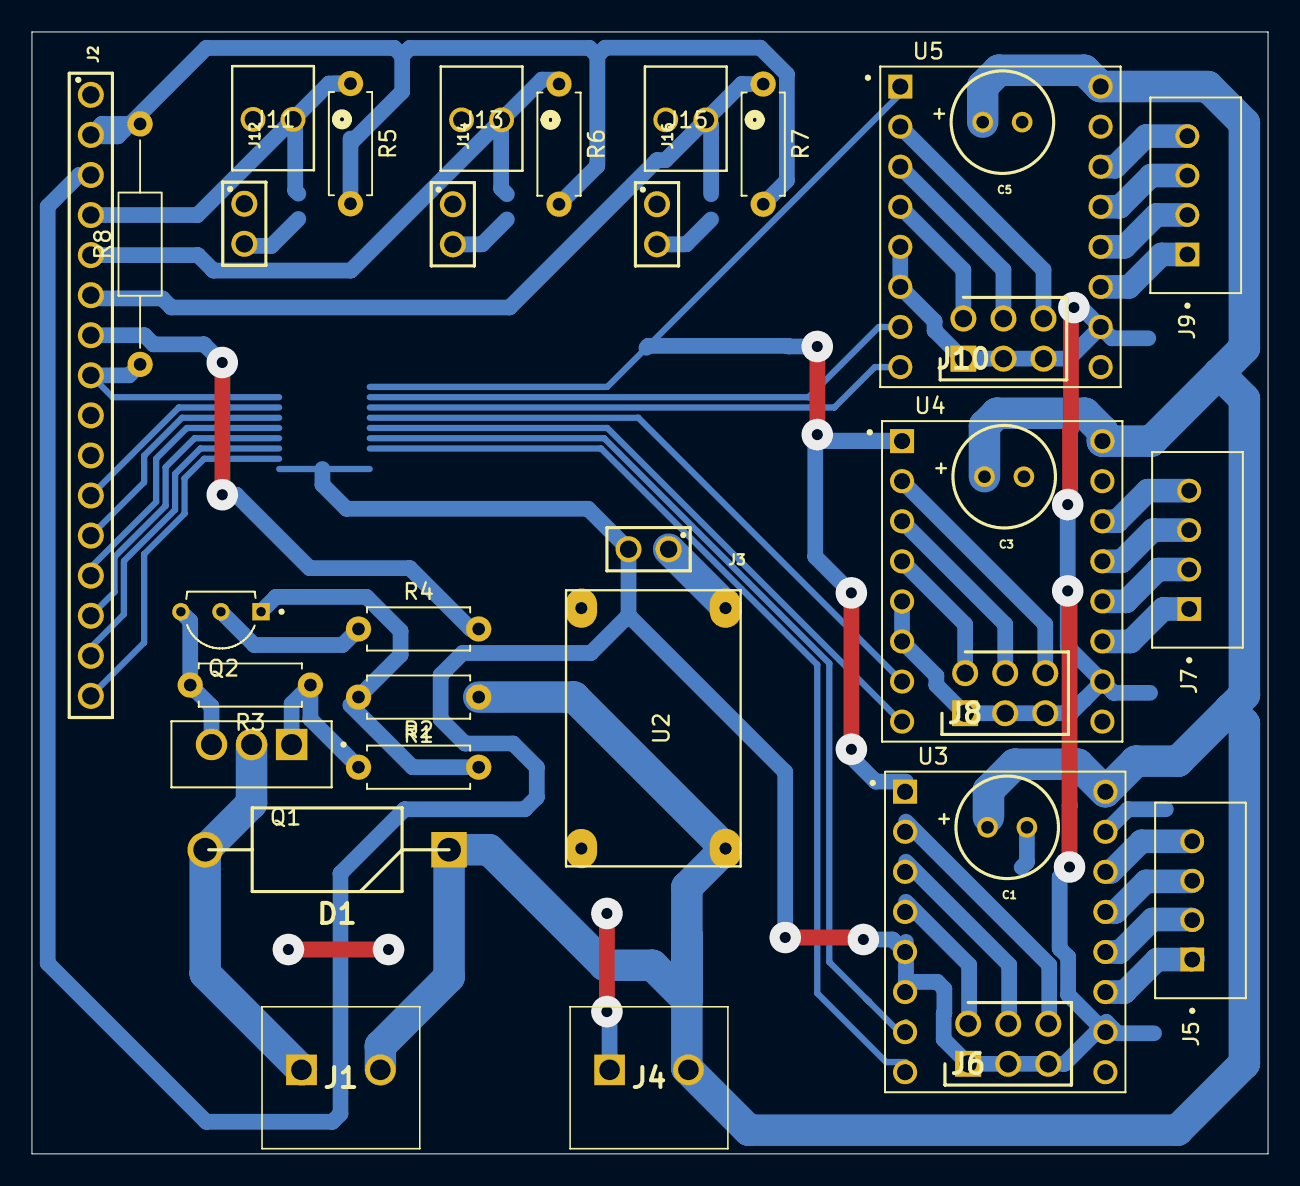
[picture p12: board cnc_driverboard.kicad_pcb from above]

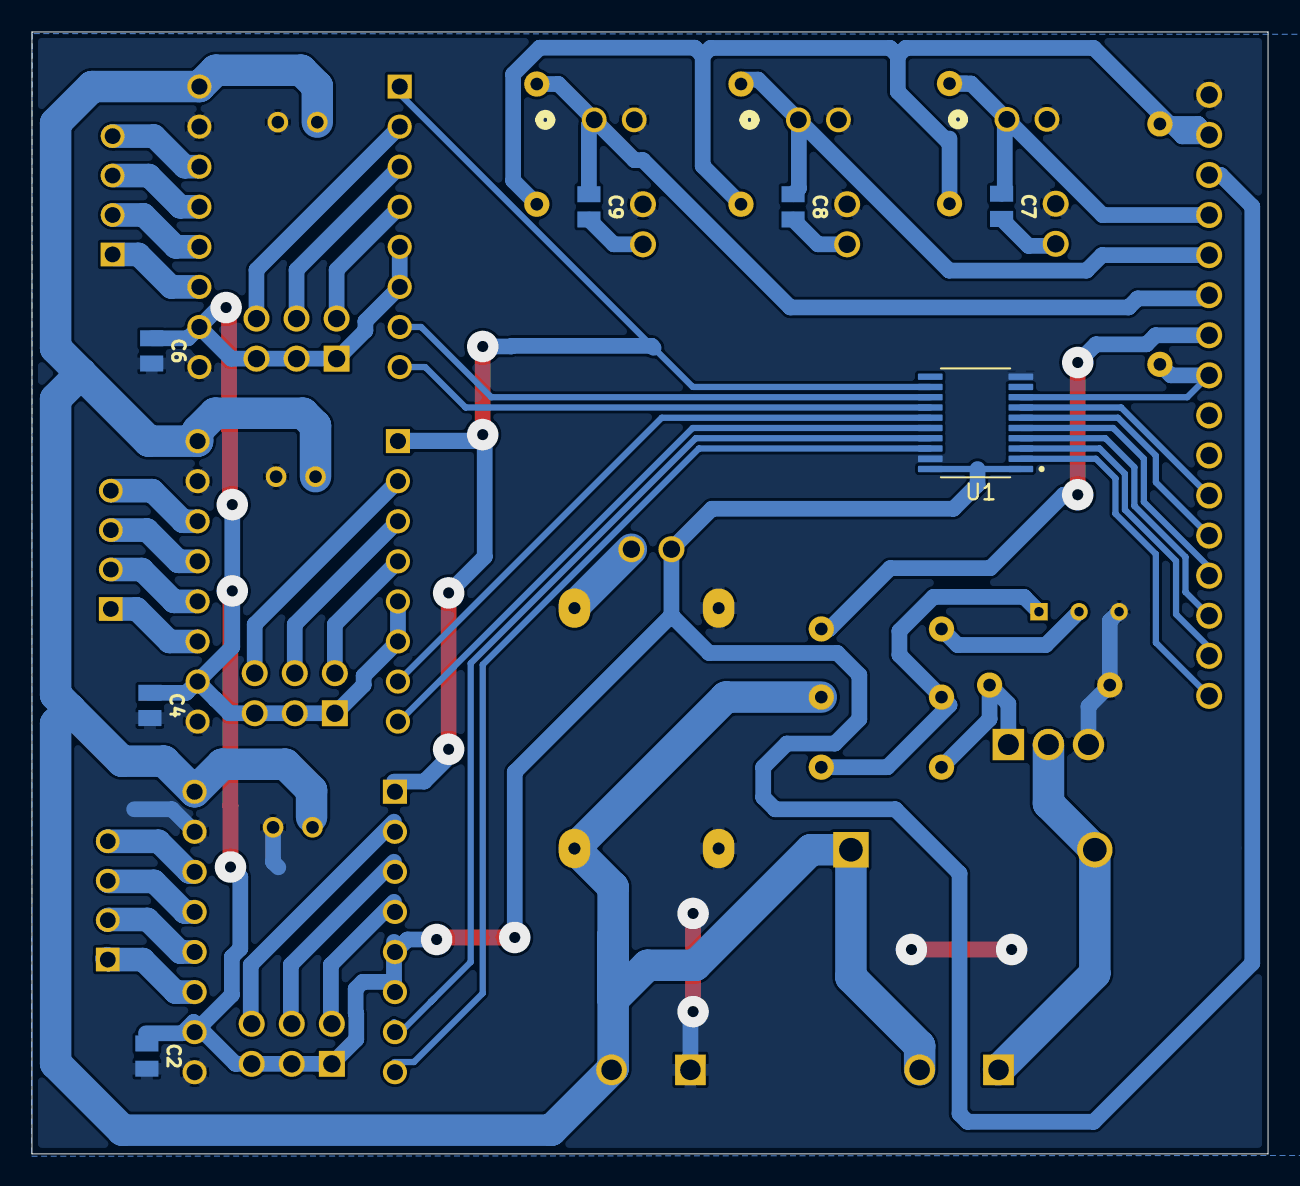
[picture p13: board cnc_driverboard.kicad_pcb from below]

Board: 2 copper layers, 78.4 x 71.1 mm, 41 parts (7 on the bottom side), 51 nets.
