fpp3/cnc/ctrl_pap/ctrl_pap/ctrl_pap.kicad_pcb

## KiCad design ctrl_pap/ctrl_pap/ctrl_pap.kicad_pcb (2026-11-11)

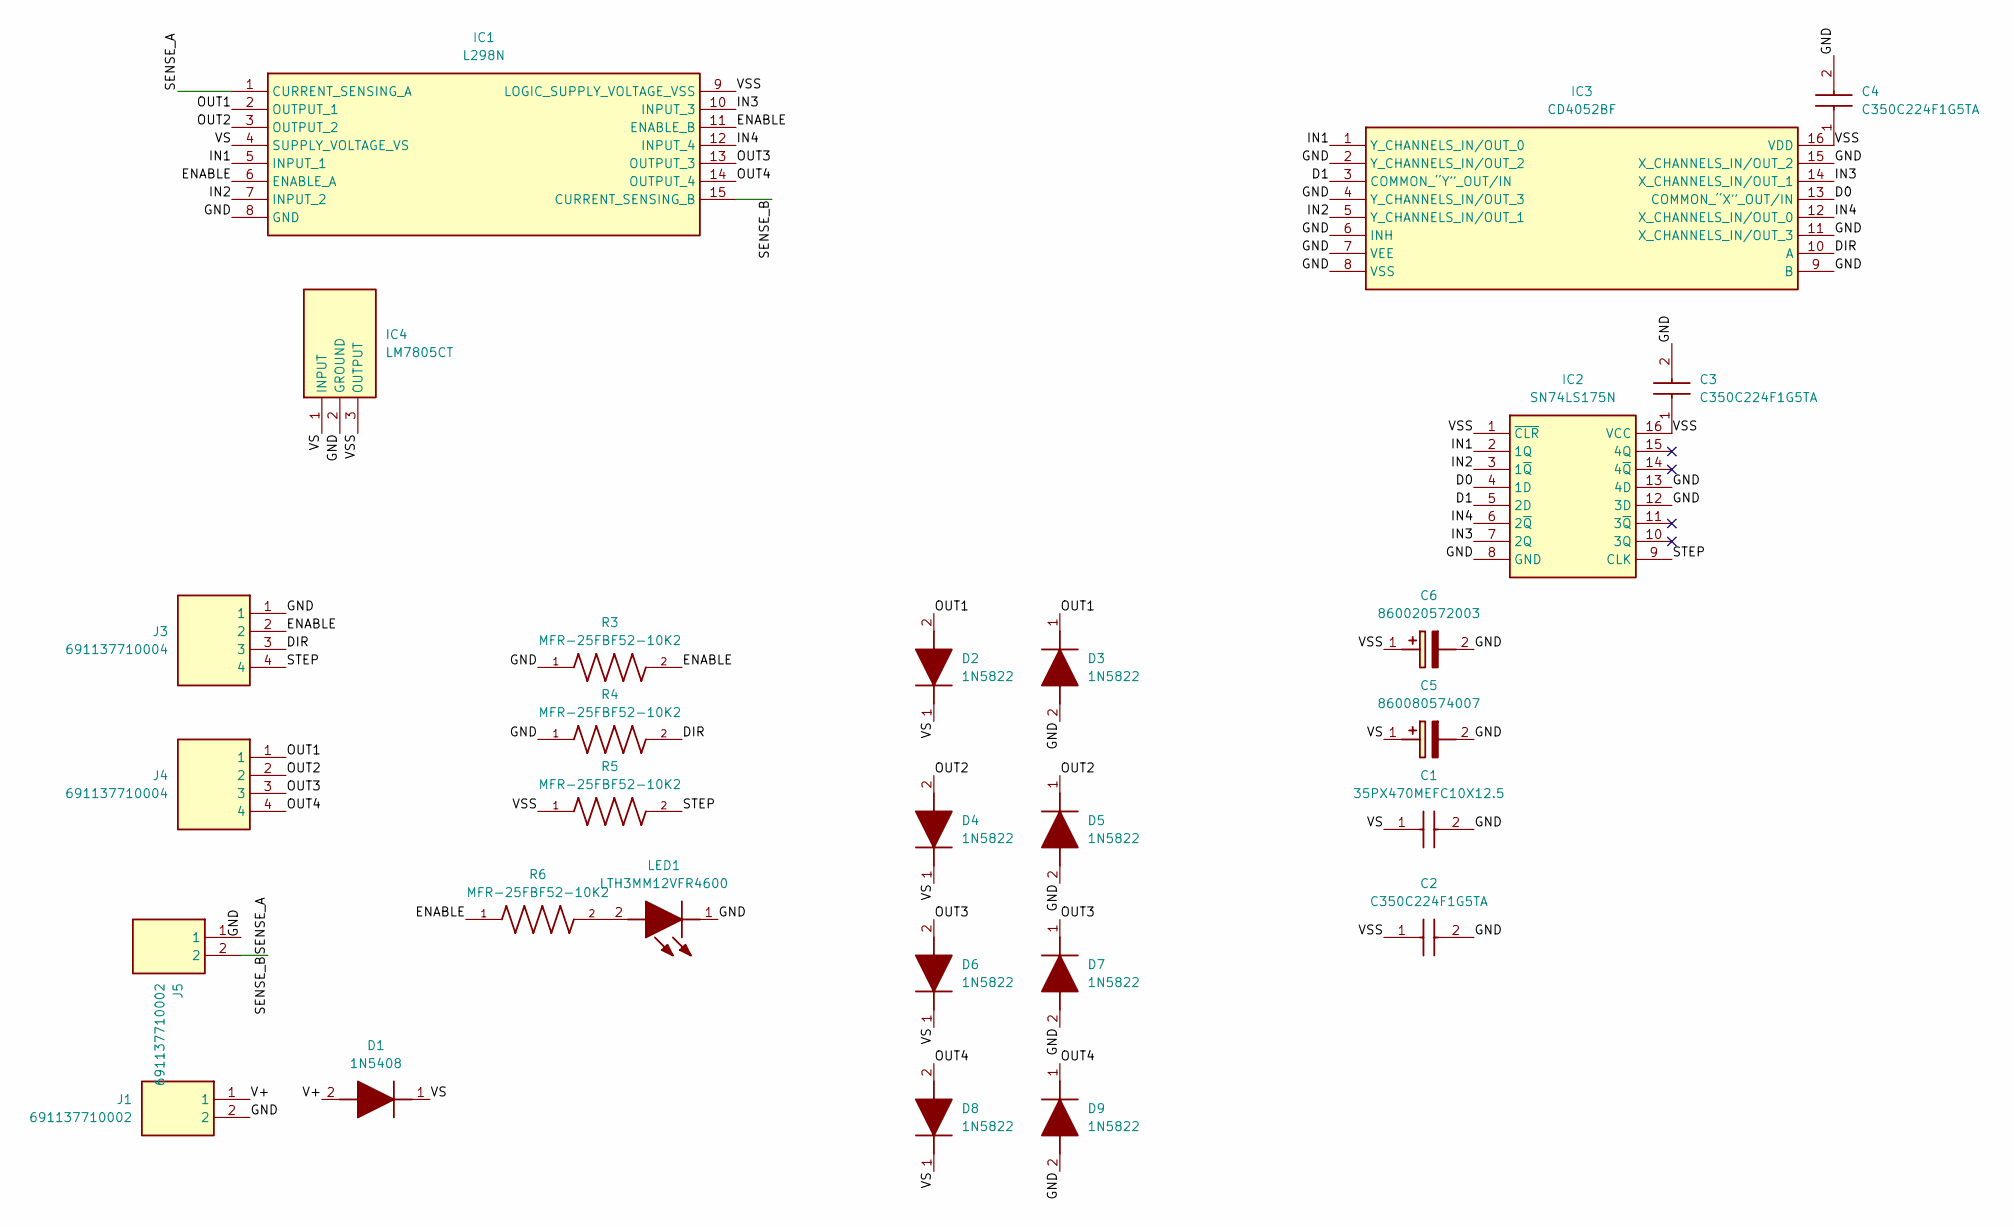
[picture p14: schematic ctrl_pap.kicad_sch]

Parts:
C1: 35PX470MEFC10X12.5; CAPPRD500W60D1025H1400; Manufacturer_Part_Number 35PX470MEFC10X12.5; Mouser Part Number 232-35PX470MEFC10X12
C2, C3, C4: C350C224F1G5TA; Manufacturer_Part_Number C350C224F1G5TA; Mouser Part Number 80-C350C224F1G5TA
C5: 860080574007; CAPPRD350W52D800H1300; Manufacturer_Part_Number 860080574007; Mouser Part Number 710-860080574007
C6: 860020572003; CAPPRD200W52D500H1250; Manufacturer_Part_Number 860020572003; Mouser Part Number 710-860020572003
D1: 1N5408; DIOAD2510W125L750D440; Manufacturer_Part_Number 1N5408; Mouser Part Number 637-1N5408
D2, D3, D4, D5, D6, D7, D8, D9: 1N5822; DIOAD3070W130L950D530; Manufacturer_Part_Number 1N5822; Mouser Part Number 512-1N5822
IC1: L298N; TO127P500X2020X2210-15P; Manufacturer_Part_Number L298N; Mouser Part Number 511-L298
IC2: SN74LS175N; DIP794W53P254L1930H508Q16N; Manufacturer_Part_Number SN74LS175N; Mouser Part Number 595-SN74LS175N
IC3: CD4052BF; CDIP762W66P254L2134H508Q16; Manufacturer_Part_Number CD4052BF; Mouser Part Number 595-CD4052BF
IC4: LM7805CT; TO254P470X1028X1955-3P; Manufacturer_Part_Number LM7805CT; Mouser Part Number 926-LM7805CT
J1, J5: 691137710002; SHDR2W70P0X500_1X2_1000X750X1150P; Manufacturer_Part_Number 691137710002; Mouser Part Number 710-691137710002
J3, J4: 691137710004; Manufacturer_Part_Number 691137710004; Mouser Part Number 710-691137710004
LED1: LTH3MM12VFR4600; Manufacturer_Part_Number LTH3MM12VFR4600; Mouser Part Number 593-LTH3MM12VFR4600
R3, R4, R5, R6: MFR-25FBF52-10K2; RESAD1100W55L680D260; PARTREV 201304

Connections:
/D0: IC2.4 (1D), IC3.13 (COMMON_“X”_OUT/IN)
/D1: IC2.5 (2D), IC3.3 (COMMON_“Y”_OUT/IN)
/DIR: IC3.10 (A), J3.3, R4.2
/ENABLE: IC1.6 (ENABLE_A), IC1.11 (ENABLE_B), J3.2, R3.2, R6.1
/GND: C1.2 (-), C2.2, C3.2, C4.2, C5.2 (-), C6.2 (-), D3.2 (A), D5.2 (A), D7.2 (A), D9.2 (A), IC1.8 (GND), IC2.8 (GND), IC2.12 (3D), IC2.13 (4D), IC3.2 (Y_CHANNELS_IN/OUT_2), IC3.4 (Y_CHANNELS_IN/OUT_3), IC3.6 (INH), IC3.7 (VEE), IC3.8 (VSS), IC3.9 (B), IC3.11 (X_CHANNELS_IN/OUT_3), IC3.15 (X_CHANNELS_IN/OUT_2), IC4.2 (GROUND), J1.2, J3.1, J5.1, LED1.1 (K), R3.1, R4.1
/IN1: IC1.5 (INPUT_1), IC2.2 (1Q), IC3.1 (Y_CHANNELS_IN/OUT_0)
/IN2: IC1.7 (INPUT_2), IC2.3 (1~Q), IC3.5 (Y_CHANNELS_IN/OUT_1)
/IN3: IC1.10 (INPUT_3), IC2.7 (2Q), IC3.14 (X_CHANNELS_IN/OUT_1)
/IN4: IC1.12 (INPUT_4), IC2.6 (2~Q), IC3.12 (X_CHANNELS_IN/OUT_0)
/OUT1: D2.2 (A), D3.1 (K), IC1.2 (OUTPUT_1), J4.1
/OUT2: D4.2 (A), D5.1 (K), IC1.3 (OUTPUT_2), J4.2
/OUT3: D6.2 (A), D7.1 (K), IC1.13 (OUTPUT_3), J4.3
/OUT4: D8.2 (A), D9.1 (K), IC1.14 (OUTPUT_4), J4.4
/SENSE_A: IC1.1 (CURRENT_SENSING_A), IC1.15 (CURRENT_SENSING_B), J5.2
/STEP: IC2.9 (CLK), J3.4, R5.2
/V+: D1.2 (A), J1.1
/VS: C1.1 (+), C5.1 (+), D1.1 (K), D2.1 (K), D4.1 (K), D6.1 (K), D8.1 (K), IC1.4 (SUPPLY_VOLTAGE_VS), IC4.1 (INPUT)
/VSS: C2.1, C3.1, C4.1, C6.1 (+), IC1.9 (LOGIC_SUPPLY_VOLTAGE_VSS), IC2.1 (~CLR), IC2.16 (VCC), IC3.16 (VDD), IC4.3 (OUTPUT), R5.1
unnamed: LED1.2 (A), R6.2

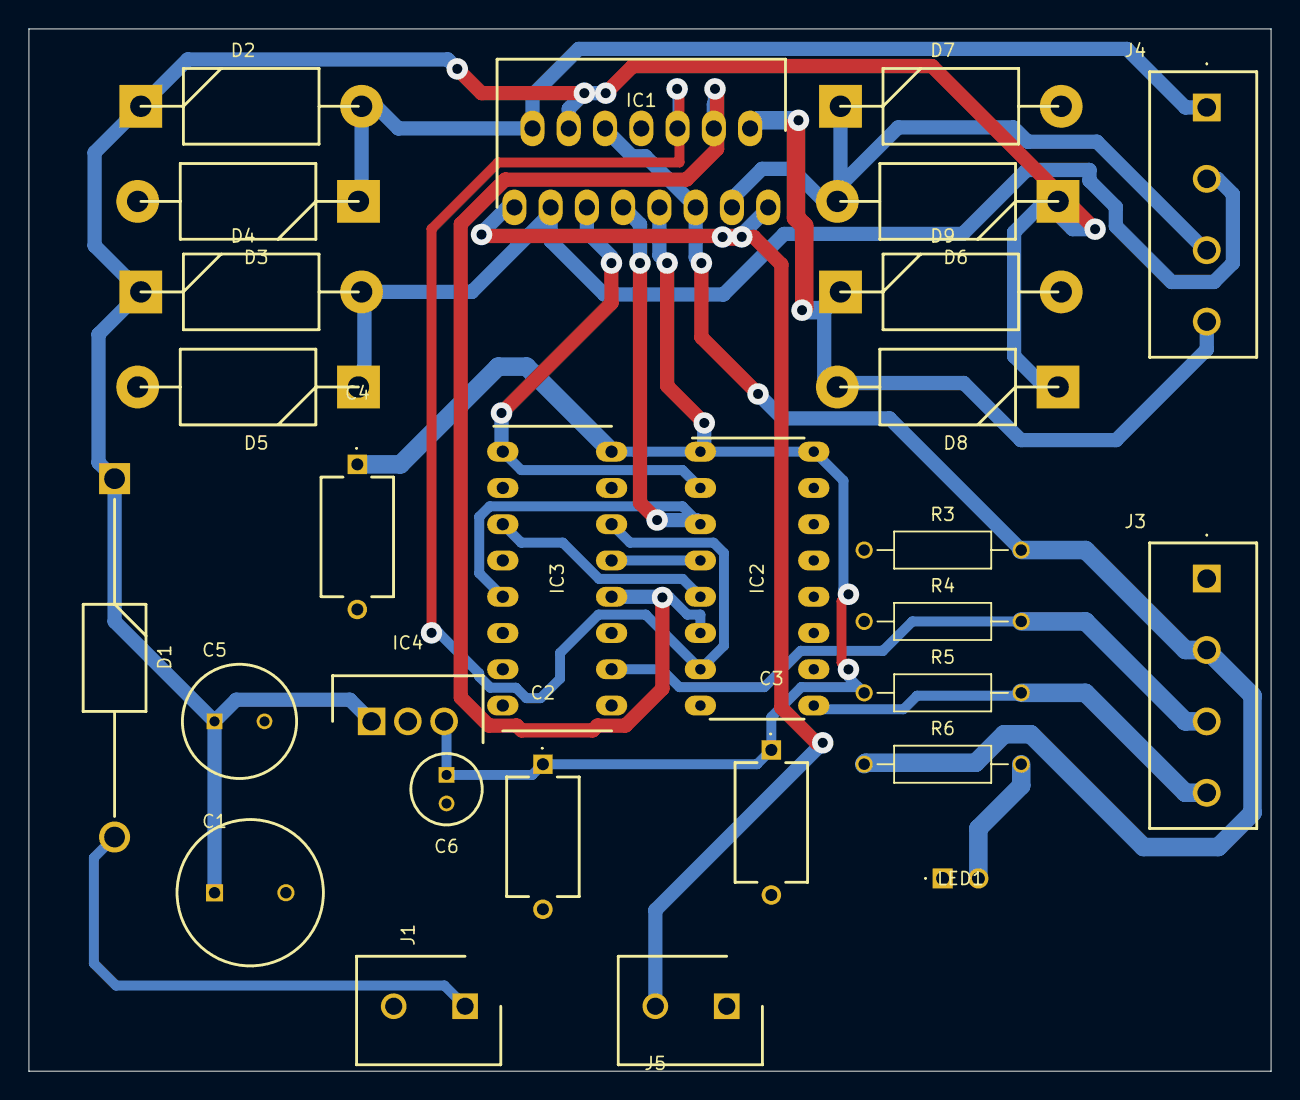
[picture p15: board ctrl_pap.kicad_pcb from above]

Board: 2 copper layers, 87.0 x 73.0 mm, 28 parts (0 on the bottom side), 19 nets.
