fpp3/cnc/ctrl_main/cnc_mainboard/cnc_mainboard.kicad_pcb

## KiCad design ctrl_main/cnc_mainboard/cnc_mainboard.kicad_pcb (2026-11-09)

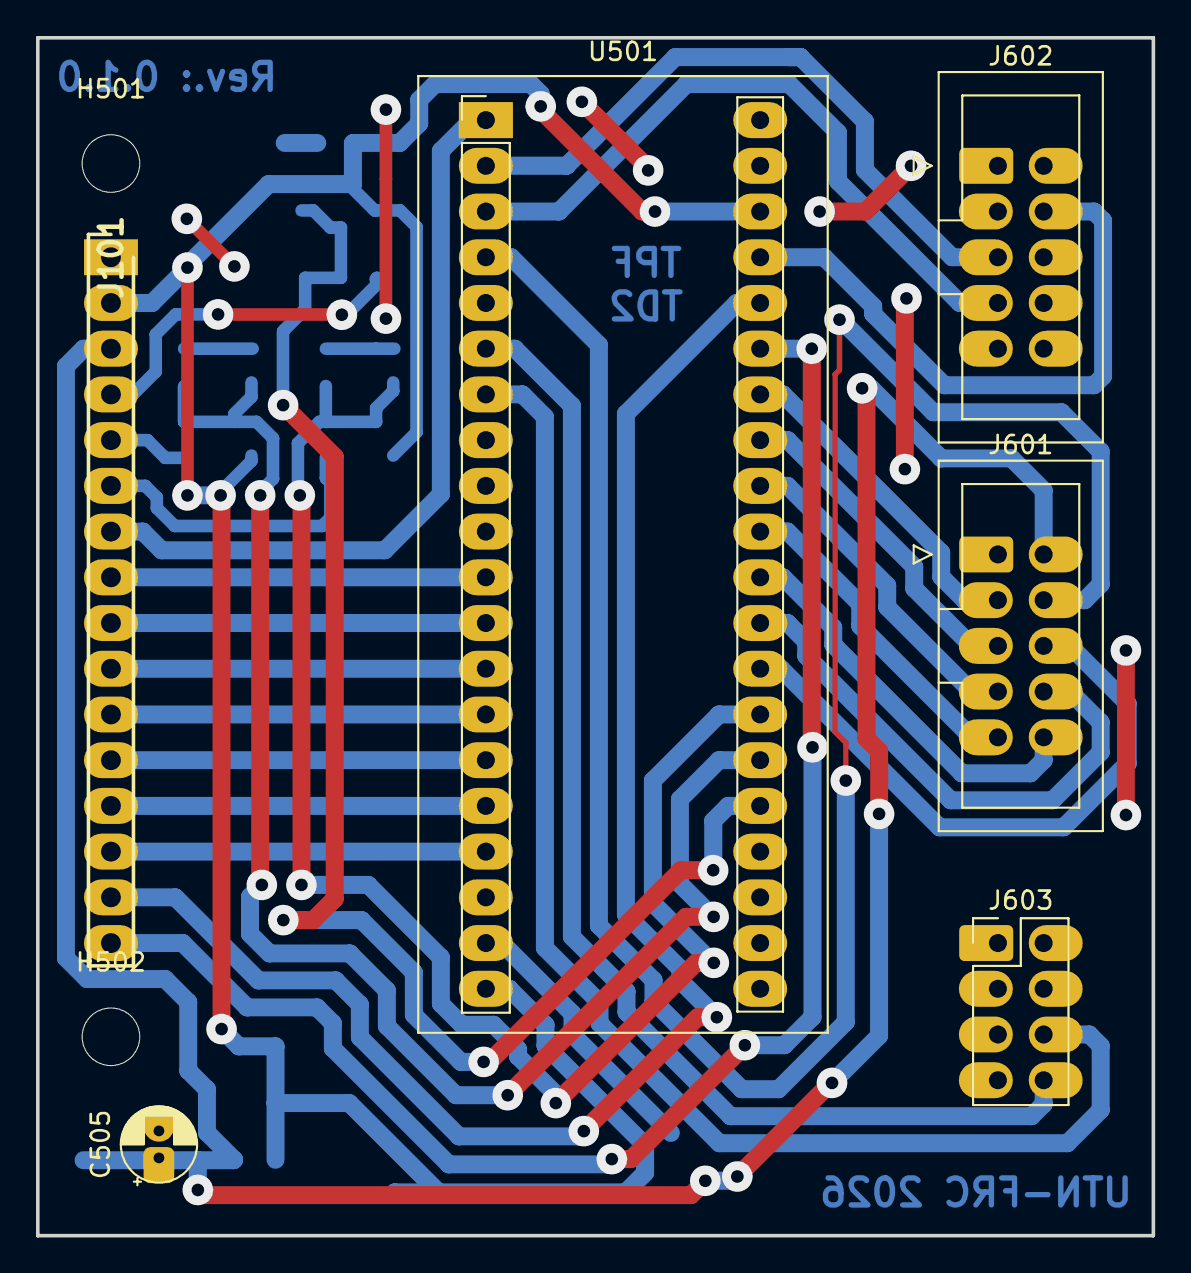
[picture p16: board cnc_mainboard.kicad_pcb from above]

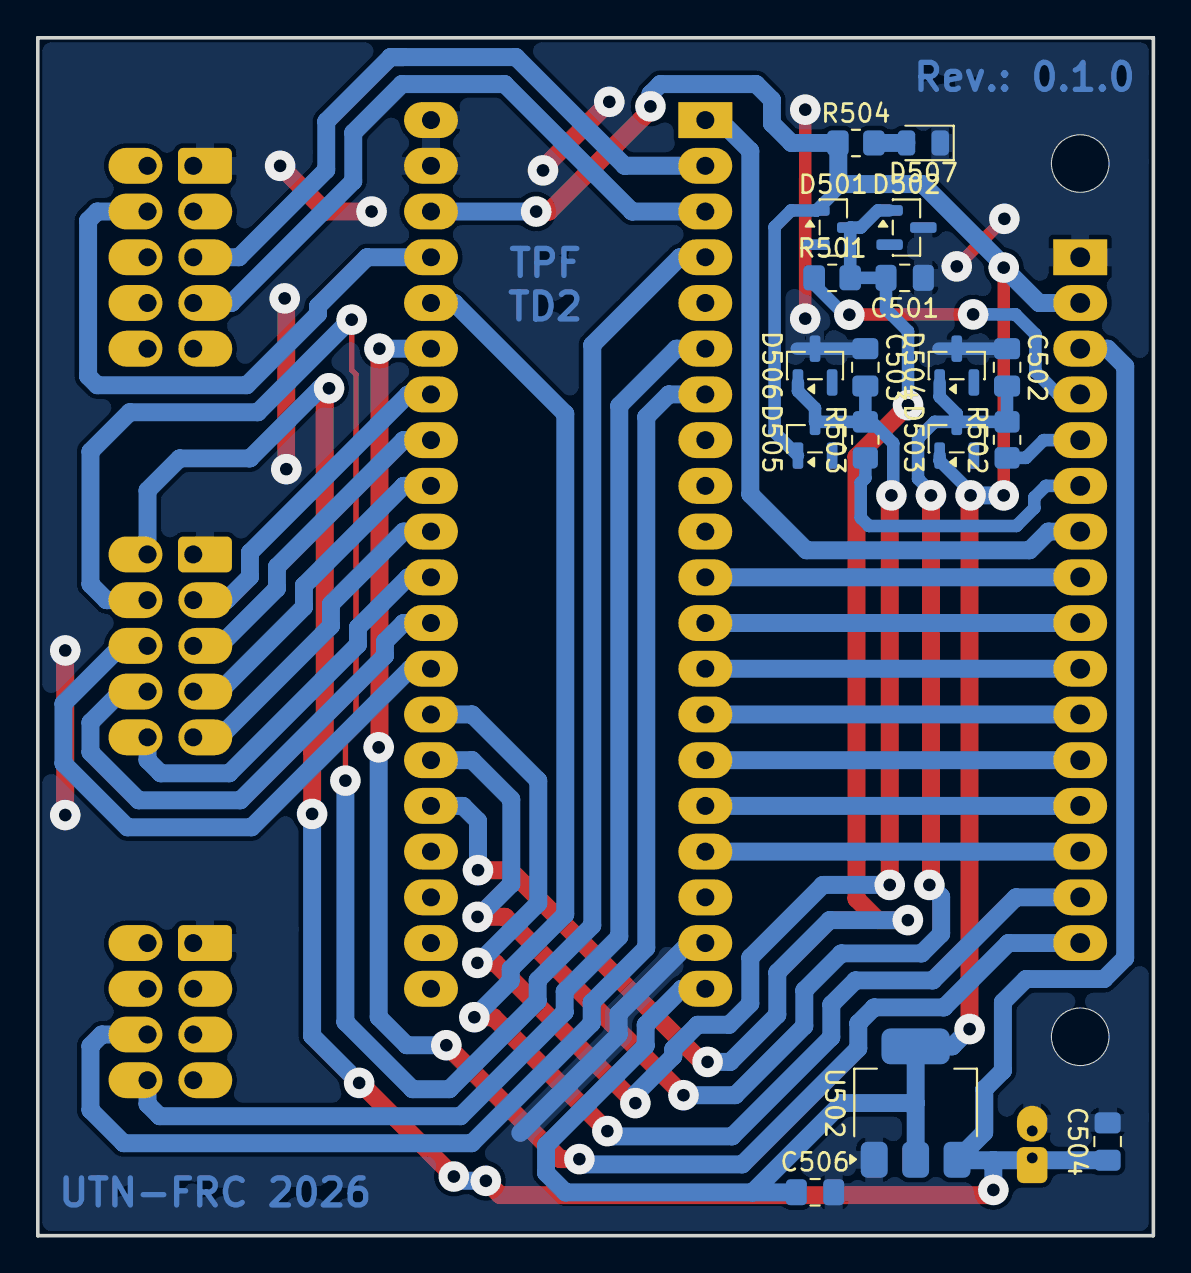
[picture p17: board cnc_mainboard.kicad_pcb from below]

Board: 2 copper layers, 62.0 x 66.5 mm, 25 parts (17 on the bottom side), 33 nets.

Parts:
C501, C502, C503, C504: 100n; C_0805_2012Metric_Pad1.18x1.45mm_HandSolder
C505: 10u; CP_Radial_D4.0mm_P1.50mm
C506: 22u; C_0805_2012Metric_Pad1.18x1.45mm_HandSolder
D501, D502, D503, D504, D505, D506: BAT54W; SOT-23
D507: LED; LED_0805_2012Metric
H501, H502: MountingHole; MountingHole_3.2mm_M3
J101: PH1-16-UA; HDRV16W64P0X254_1X16_4064X250X847P
J601, J602: Conn_02x05_Odd_Even; IDC-Header_2x05_P2.54mm_Vertical
J603: Conn_02x04_Odd_Even; PinHeader_2x04_P2.54mm_Vertical
R501, R502, R503: 10K; R_0805_2012Metric_Pad1.20x1.40mm_HandSolder
R504: 330; R_0805_2012Metric_Pad1.20x1.40mm_HandSolder
U501: YAAJ_BluePill; YAAJ_BluePill_2
U502: AMS1117-3.3; SOT-223-3_TabPin2

Connections:
/Core Board Bluepill/+3V3: C506.1, D501.1 (A), D503.1 (A), D505.1 (A), J101.2, R504.1, U501.20 (3V3), U501.38 (3V3), U502.2 (VO)
/Core Board Bluepill/+5V: C504.1, C505.1, J101.3, J601.2, U502.3 (VI)
/Core Board Bluepill/EXT_X_END: J101.4, R501.1
/Core Board Bluepill/EXT_Y_END: J101.5, R502.1
/Core Board Bluepill/EXT_Z_END: J101.6, R503.1
/Core Board Bluepill/GND: C501.1, C502.1, C503.1, C504.2, C505.2, C506.2, D502.3 (K), D504.3 (K), D506.3 (K), D507.1 (K), J101.1, J601.1, J602.1, J603.1, U501.19 (GND), U501.39 (GND), U501.40 (GND), U502.1 (GND)
/Core Board Bluepill/GPIO0: J601.6, U501.28 (PA3)
/Core Board Bluepill/GPIO1: J601.8, U501.29 (PA4)
/Core Board Bluepill/GPIO2: J601.10, U501.30 (PA5)
/Core Board Bluepill/GPIO3: J601.9, U501.31 (PA6)
/Core Board Bluepill/GPIO4: J601.7, U501.32 (PA7)
/Core Board Bluepill/GPIO5: J601.5, U501.33 (PB0)
/Core Board Bluepill/GPIO6: J601.3, U501.34 (PB1)
/Core Board Bluepill/GPIO7: J602.5, U501.2 (PB13)
/Core Board Bluepill/GPIO8: J602.7, U501.3 (PB14)
/Core Board Bluepill/GPIO9: J601.4, U501.4 (PB15)
/Core Board Bluepill/RESET: J602.4, U501.37 (RST)
/Core Board Bluepill/SPINDLE_PWM: J101.7, U501.1 (PB12)
/Core Board Bluepill/USART1_RX: J603.6, U501.7 (PA10)
/Core Board Bluepill/USART1_TX: J603.8, U501.6 (PA9)
/Core Board Bluepill/X_DIR: J101.9, U501.12 (PB4)
/Core Board Bluepill/X_EN: J101.8, U501.11 (PB3)
/Core Board Bluepill/X_END: C501.2, D501.3 (K), D502.1 (A), R501.2, U501.25 (PA0)
/Core Board Bluepill/X_STEP: J101.10, U501.13 (PB5)
/Core Board Bluepill/Y_DIR: J101.12, U501.15 (PB7)
/Core Board Bluepill/Y_EN: J101.11, U501.14 (PB6)
/Core Board Bluepill/Y_END: C502.2, D503.3 (K), D504.1 (A), R502.2, U501.26 (PA1)
/Core Board Bluepill/Y_STEP: J101.13, U501.16 (PB8)
/Core Board Bluepill/Z_DIR: J101.15, U501.36 (PB11)
/Core Board Bluepill/Z_EN: J101.14, U501.17 (PB9)
/Core Board Bluepill/Z_END: C503.2, D505.3 (K), D506.1 (A), R503.2, U501.27 (PA2)
/Core Board Bluepill/Z_STEP: J101.16, U501.35 (PB10)
unnamed: D507.2 (A), R504.2
