fpp3/cnc/(commit log)

2026-10-02 Agrega simulacion de la logica del controladr pap
2026-10-20 Agrega pcb con modelos incrustados
2026-11-07 Agrega esquematico para version simplificada con bluepill
2026-11-07 Agrega regulador 3.3v bluepill y cambia bat54s por bat54
2026-11-09 added SOM bluepill PCB
2026-11-09 Termina diseño pcb
2026-11-10 added Driver board and Ctrl PaP
2026-11-11 corregido Enable en Driver y añadida simulacion logica de Driver PaP
